ghaithmhamd/ESP32-drone-Stabilation-Mode-with_ESP32CAM-V2.0/Schematics.pdf

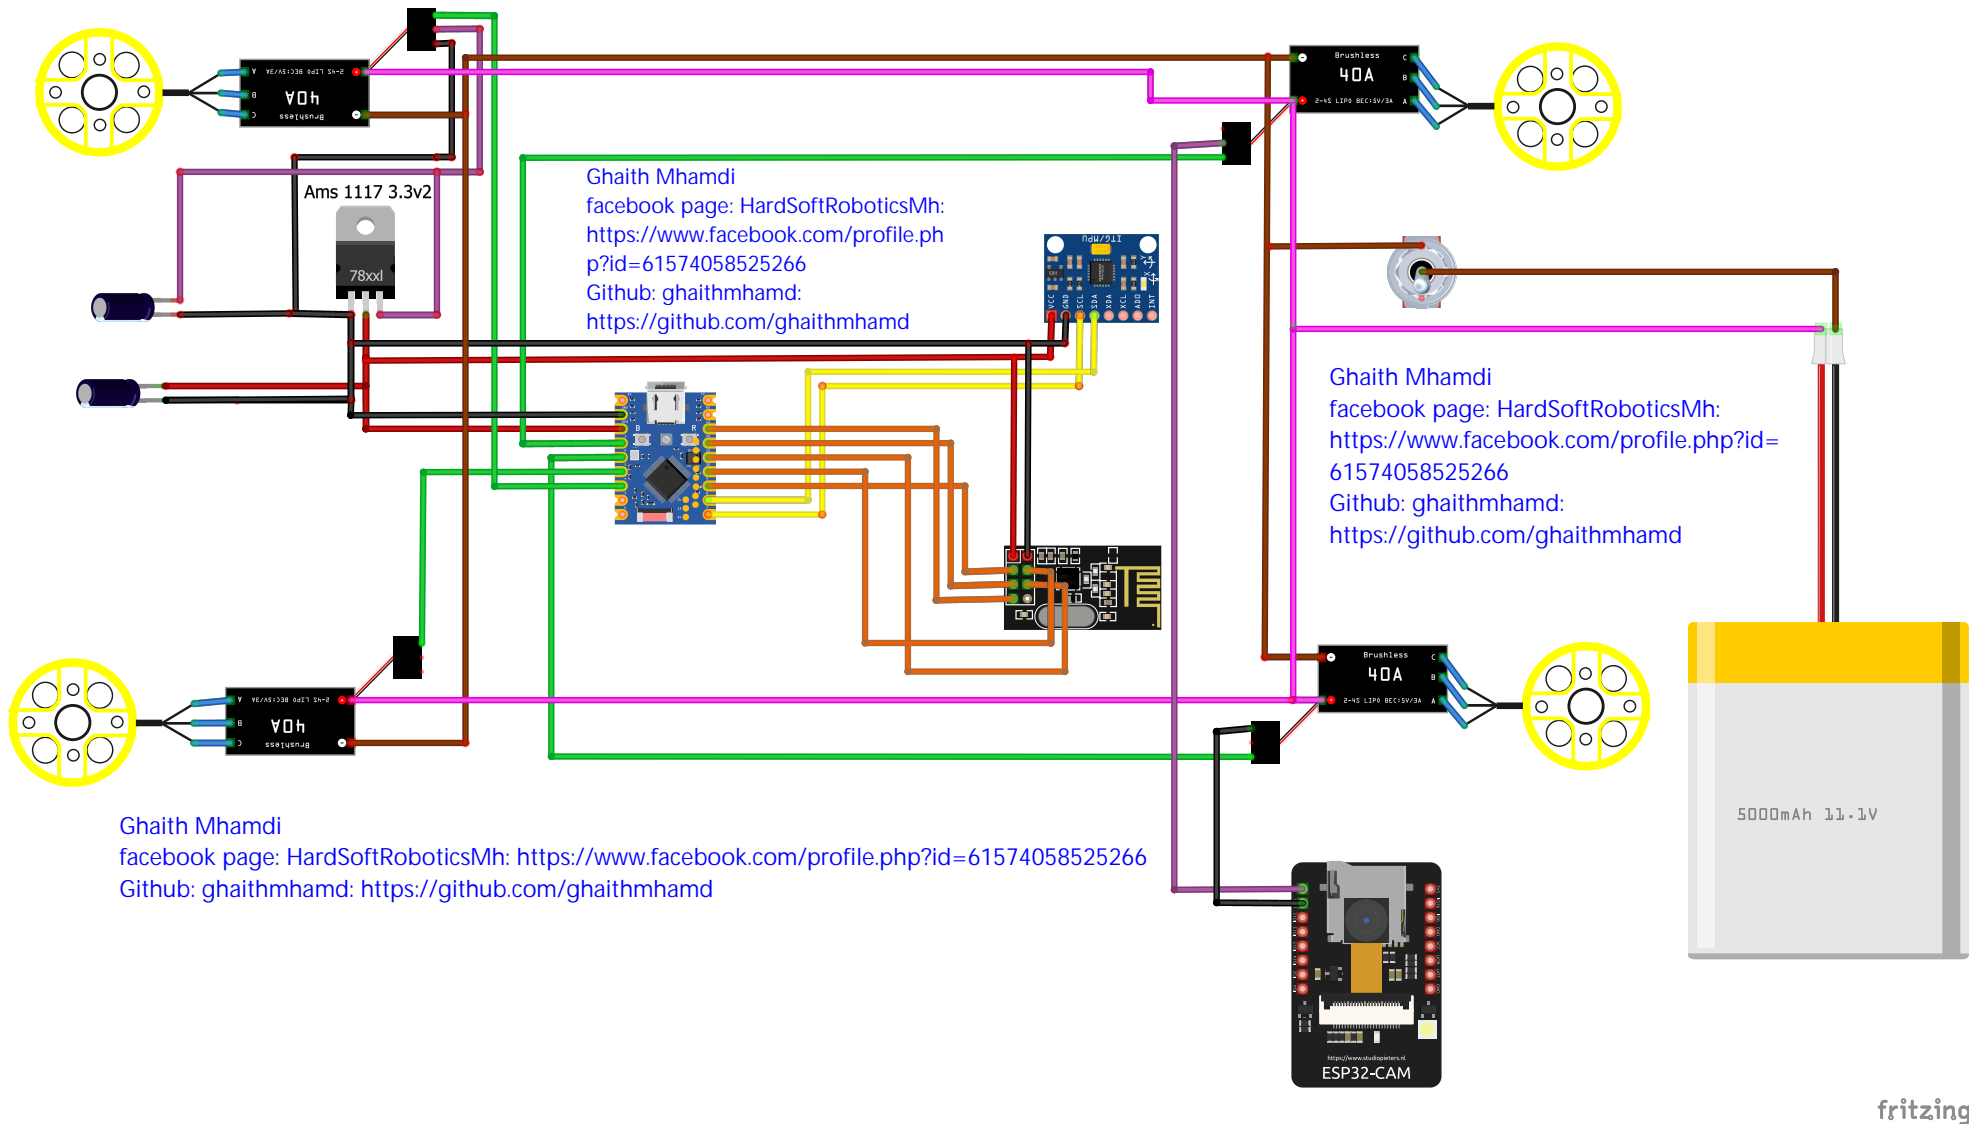
[picture p5: page 1]
