ghaithmhamd/ESP32-drone-Stabilation-Mode-with_ESP32CAM-V2.0/(commit log)

2025-04-05 Update and rename brusheless_drone_v1.0_Servo_pid_kalmanFilter_esp32s3Zero.ino to Arduino Code eso32s3Zero Drone.ino
2025-04-05 Rename esp32 drone with camera v2.0.pdf to Schematics.pdf
