ghaithmhamd/ESP32-drone-Stabilation-Mode-with_ESP32CAM-V2.0/(notices)

Notices in the files:
README.md:
License: MIT
